INTechSenpai/sumobot/Doc positions capteur.png

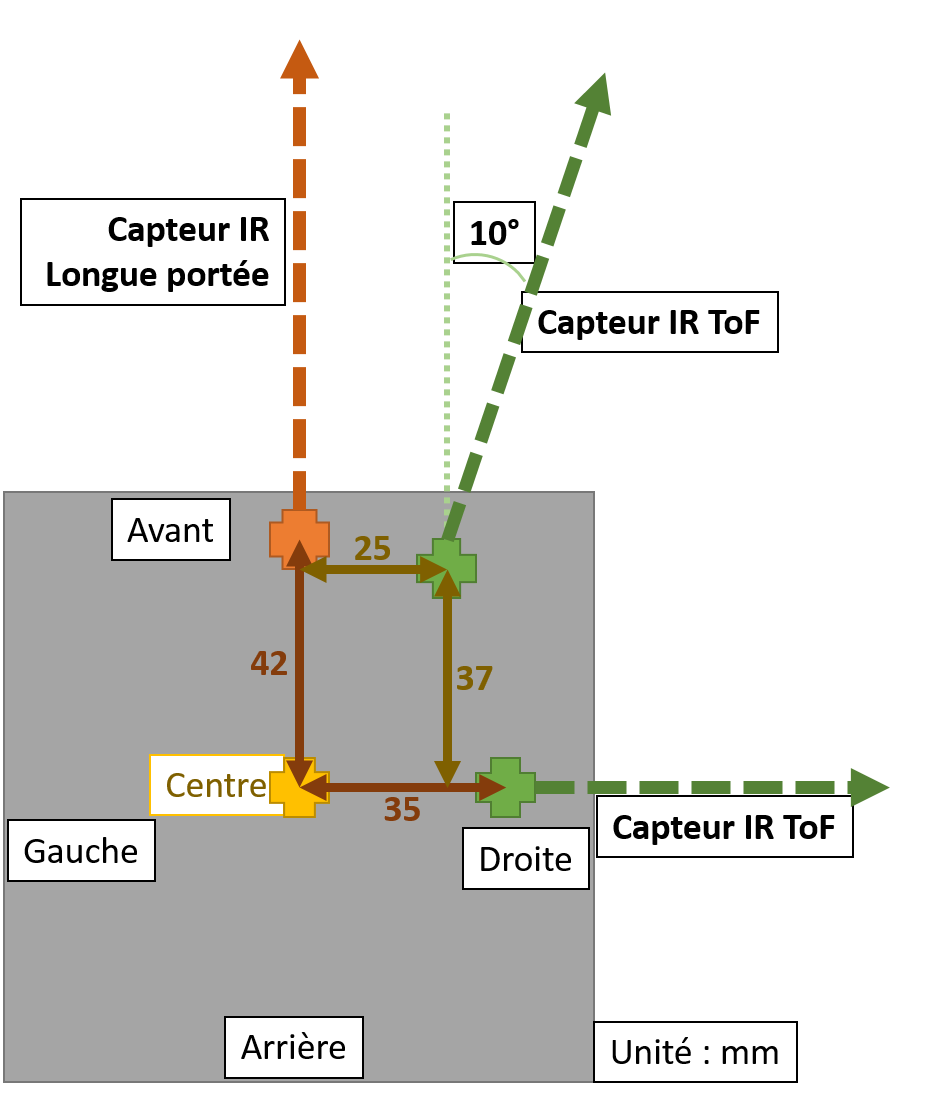
Doc positions capteur.png
