INTechSenpai/sumobot/programmation/UML/UML.png

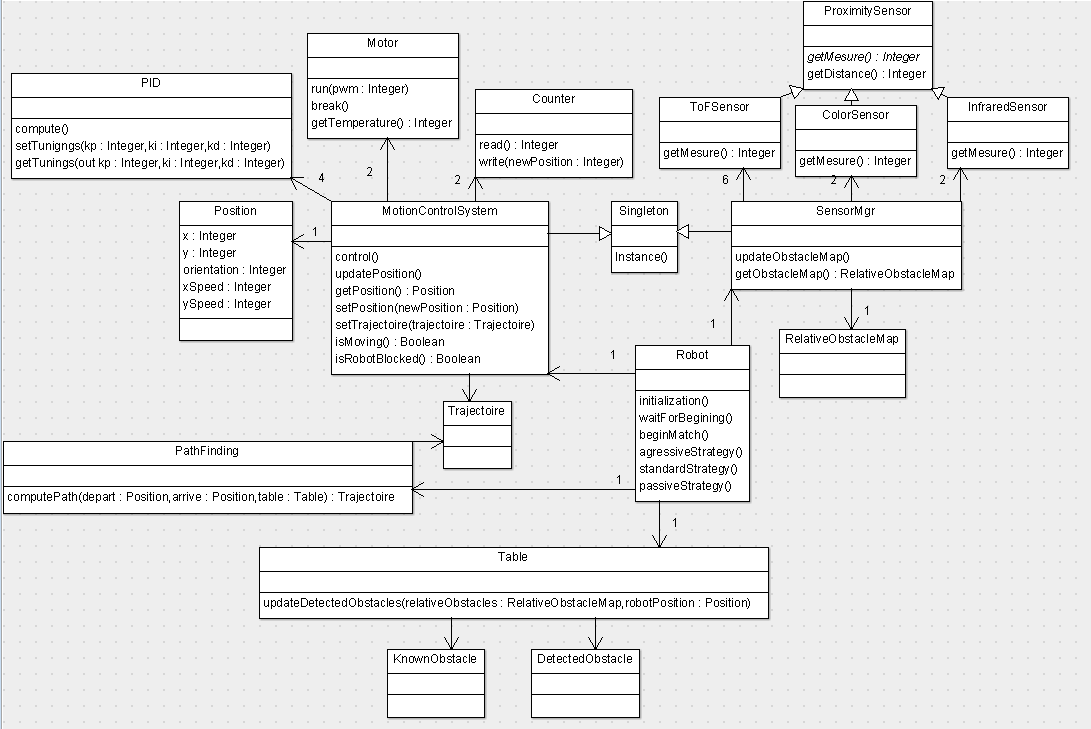
programmation/UML/UML.png
