INTechSenpai/sumobot/electronique/mainBoard.brd

## EAGLE design electronique/mainBoard.brd (2016-02-20)

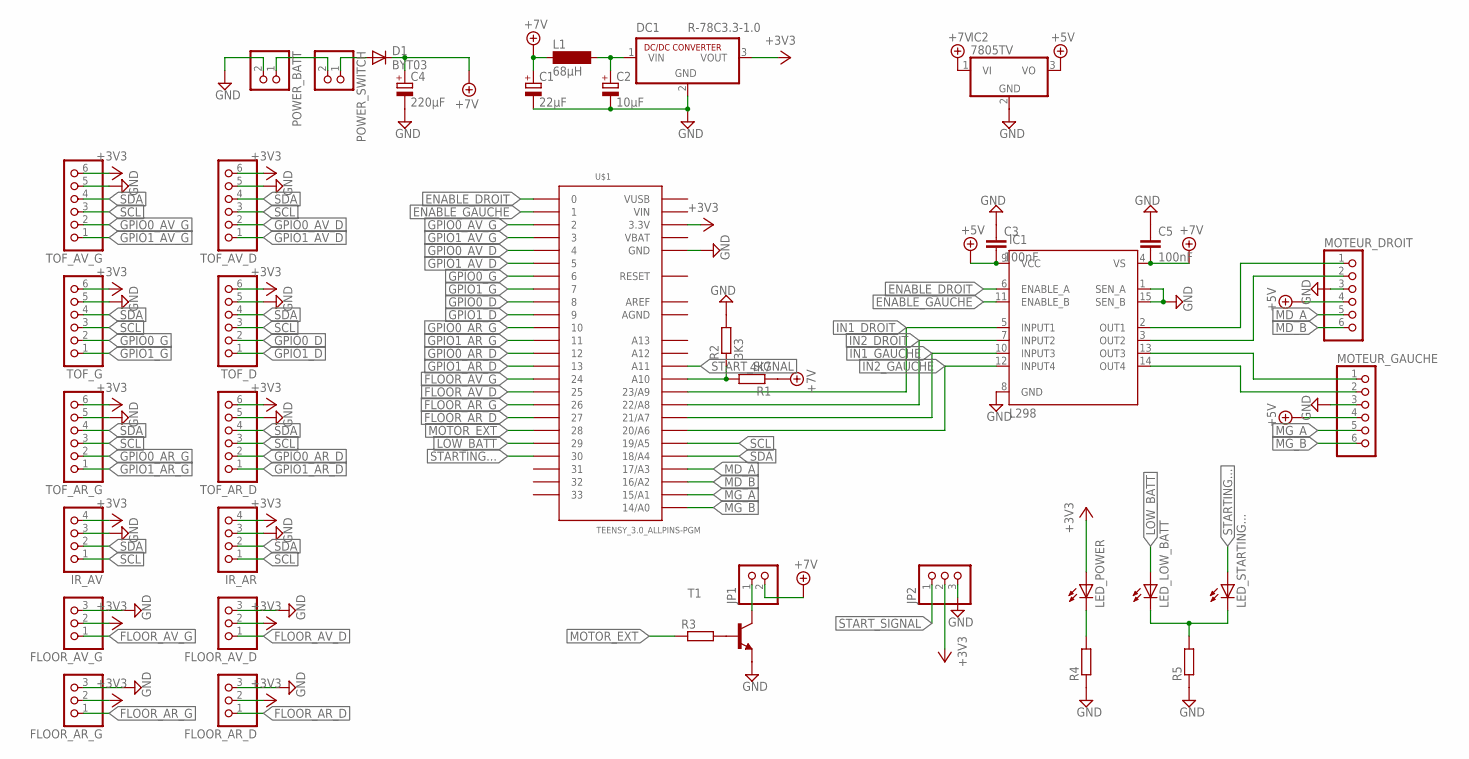
[picture p3: schematic mainBoard.sch]

Parts:
C1: 22µF; E2,5-6E
C2: 10µF; E2,5-6E
C3, C5: 100nF; C050-024X044
C4: 220µF; E2,5-7
D1: BYT03; DO27-15
DC1: R-78C3.3-1.0; SIP3
FLOOR_AR_D: PINHD-1X3; 1X03
FLOOR_AR_G: PINHD-1X3; 1X03
FLOOR_AV_D: PINHD-1X3; 1X03
FLOOR_AV_G: PINHD-1X3; 1X03
IC1: L298; MULTIWATT-15
IC2: 7805TV; TO220V
IR_AR: PINHD-1X4; 1X04
IR_AV: PINHD-1X4; 1X04
JP1: PINHD-1X2; 1X02
JP2: PINHD-1X3; 1X03
L1: 68µH; BS11
LED_LOW_BATT: LED3MM
LED_POWER: LED3MM
LED_STARTING...: LED3MM
MOTEUR_DROIT: PINHD-1X6; 1X06
MOTEUR_GAUCHE: PINHD-1X6; 1X06
POWER_BATT: PINHD-1X2; 1X02
POWER_SWITCH: PINHD-1X2; 1X02
R1: 4K7; 0204/7
R2: 3K3; 0204/7
R3, R4: R-EU_0204/7; 0204/7
R5: R-EU_0207/2V; 0207/2V
T1: 2N4124-NPN-TO92-CBE; TO92-CBE
TOF_AR_D: PINHD-1X6; 1X06
TOF_AR_G: PINHD-1X6; 1X06
TOF_AV_D: PINHD-1X6; 1X06
TOF_AV_G: PINHD-1X6; 1X06
TOF_D: PINHD-1X6; 1X06
TOF_G: PINHD-1X6; 1X06
U$1: TEENSY_3.0_ALLPINS-PGM

Connections:
+3V3: DC1.3 (VOUT), FLOOR_AR_D.2, FLOOR_AR_G.2, FLOOR_AV_D.2, FLOOR_AV_G.2, IR_AR.4, IR_AV.4, JP2.2, LED_POWER.A, TOF_AR_D.6, TOF_AR_G.6, TOF_AV_D.6, TOF_AV_G.6, TOF_D.6, TOF_G.6, U$1.3.3V, U$1.3.3V1 (3.3V), U$1.3.3V2 (3.3V)
+5V: C3.2, IC1.9 (VCC), IC2.3 (VO), MOTEUR_DROIT.4, MOTEUR_GAUCHE.4
+7V: C1.+, C4.+, C5.2, D1.C, IC1.4 (VS), IC2.1 (VI), JP1.2, L1.1, R1.1
AGND: U$1.AGND
AREF: U$1.AREF
ENABLE_DROIT: IC1.6 (ENABLE_A), U$1.0
ENABLE_GAUCHE: IC1.11 (ENABLE_B), U$1.1
FLOOR_AR_D: FLOOR_AR_D.1, U$1.27
FLOOR_AR_G: FLOOR_AR_G.1, U$1.26
FLOOR_AV_D: FLOOR_AV_D.1, U$1.25
FLOOR_AV_G: FLOOR_AV_G.1, U$1.24
GND: C1.-, C2.-, C3.1, C4.-, C5.1, DC1.2 (GND), FLOOR_AR_D.3, FLOOR_AR_G.3, FLOOR_AV_D.3, FLOOR_AV_G.3, IC1.1 (SEN_A), IC1.8 (GND), IC1.15 (SEN_B), IC2.2 (GND), IR_AR.3, IR_AV.3, JP2.3, MOTEUR_DROIT.3, MOTEUR_GAUCHE.3, POWER_BATT.2, R2.2, R4.1, R5.1, T1.E, TOF_AR_D.5, TOF_AR_G.5, TOF_AV_D.5, TOF_AV_G.5, TOF_D.5, TOF_G.5, U$1.GND, U$1.GND1 (GND), U$1.GND2 (GND)
GPIO0_AR_D: TOF_AR_D.2, U$1.12
GPIO0_AR_G: TOF_AR_G.2, U$1.10
GPIO0_AV_D: TOF_AV_D.2, U$1.4
GPIO0_AV_G: TOF_AV_G.2, U$1.2
GPIO0_D: TOF_D.2, U$1.8
GPIO0_G: TOF_G.2, U$1.6
GPIO1_AR_D: TOF_AR_D.1, U$1.13
GPIO1_AR_G: TOF_AR_G.1, U$1.11
GPIO1_AV_D: TOF_AV_D.1, U$1.5
GPIO1_AV_G: TOF_AV_G.1, U$1.3
GPIO1_D: TOF_D.1, U$1.9
GPIO1_G: TOF_G.1, U$1.7
IN1_DROIT: IC1.5 (INPUT1), U$1.23/A9
IN1_GAUCHE: IC1.10 (INPUT3), U$1.21/A7
IN2_DROIT: IC1.7 (INPUT2), U$1.22/A8
IN2_GAUCHE: IC1.12 (INPUT4), U$1.20/A6
LOW_BATT: LED_LOW_BATT.A, U$1.29
MD_A: MOTEUR_DROIT.5, U$1.17/A3
MD_B: MOTEUR_DROIT.6, U$1.16/A2
MD_OUT_A: IC1.2 (OUT1), MOTEUR_DROIT.1
MD_OUT_B: IC1.3 (OUT2), MOTEUR_DROIT.2
MG_A: MOTEUR_GAUCHE.5, U$1.15/A1
MG_B: MOTEUR_GAUCHE.6, U$1.14/A0
MG_OUT_A: IC1.13 (OUT3), MOTEUR_GAUCHE.1
MG_OUT_B: IC1.14 (OUT4), MOTEUR_GAUCHE.2
MOTOR_EXT: R3.1, U$1.28
unnamed: R3.2, T1.B
unnamed: C2.+, DC1.1 (VIN), L1.2
unnamed: JP1.1, T1.C
unnamed: POWER_BATT.1, POWER_SWITCH.2
unnamed: D1.A, POWER_SWITCH.1
unnamed: LED_POWER.K (C), R4.2
unnamed: R1.2, R2.1, U$1.A10
unnamed: LED_LOW_BATT.K (C), LED_STARTING....K (C), R5.2
SCL: IR_AR.1, IR_AV.1, TOF_AR_D.3, TOF_AR_G.3, TOF_AV_D.3, TOF_AV_G.3, TOF_D.3, TOF_G.3, U$1.19/A5
SDA: IR_AR.2, IR_AV.2, TOF_AR_D.4, TOF_AR_G.4, TOF_AV_D.4, TOF_AV_G.4, TOF_D.4, TOF_G.4, U$1.18/A4
STARTING...: LED_STARTING....A, U$1.30
START_SIGNAL: JP2.1, U$1.A11
VBAT: U$1.VBAT
VIN: U$1.VIN
VUSB: U$1.VUSB

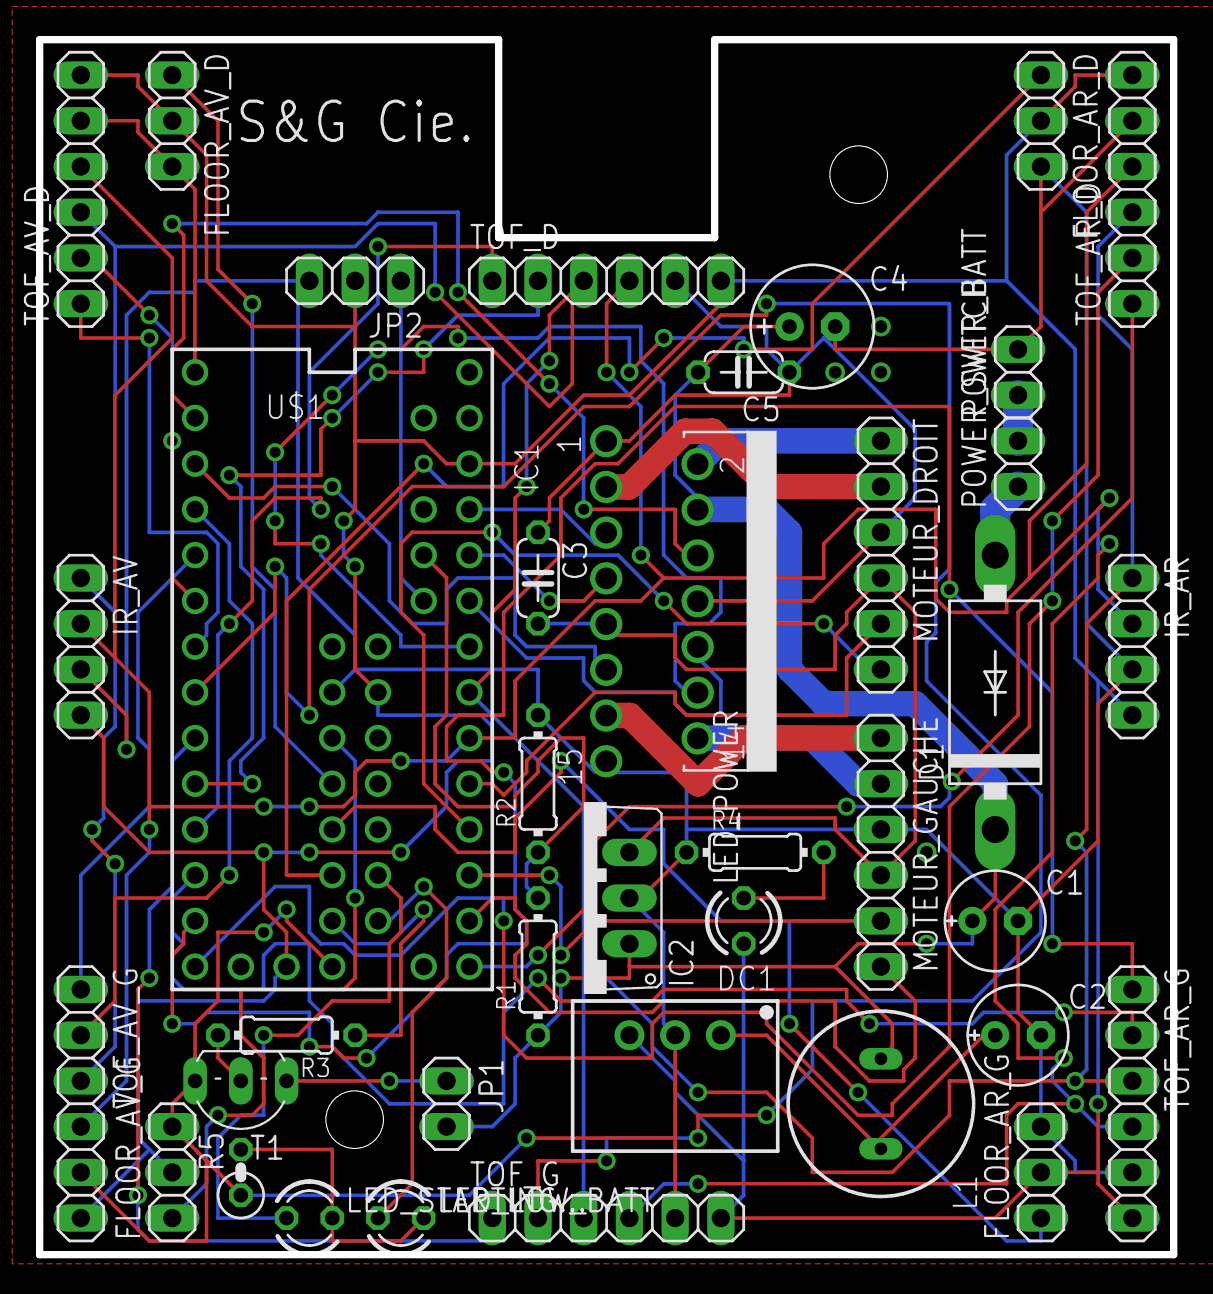
[picture p4: board mainBoard.brd from above]

Board: 2 copper layers, 63.0 x 67.5 mm, 38 parts (0 on the bottom side), 48 nets.
