INTechSenpai/sumobot/programmation/sumobot/MotionControlSystem.h

// MotionControlSystem.h

#ifndef _MOTIONCONTROLSYSTEM_h
#define _MOTIONCONTROLSYSTEM_h

#if defined(ARDUINO) && ARDUINO >= 100
	#include "arduino.h"
#else
	#include "WProgram.h"
#endif

#include "Singleton.h"
#include "Motor.h"
#include "PID.h"
#include "Average.h"
#include "Encoder.h"
#include "Path.h"
#include "Position.h"
#include "utils.h"
#include <math.h>

#define PIN_A_LEFT_ENCODER	15
#define PIN_B_LEFT_ENCODER	14
#define PIN_A_RIGHT_ENCODER	17
#define PIN_B_RIGHT_ENCODER	16

#define ROBOT_RADIUS		45.0	// Rayon du robot, en mm

#define FREQ_ASSERV			2000	// Fréquence d'asservissement (en Hz)
#define AVERAGE_SPEED_SIZE	50		// Nombre de valeurs à utiliser dans le calcul de la moyenne glissante permettant de lisser la mesure de vitesse
#define TRACKER_SIZE		1	 	// Nombre d'états consécutifs du système à stocker pour le débug

#define ERROR_AFTER_ROTATION	0.02	// Incrément de l'erreur sur l'orientation après une rotation pure, en radians
#define ERROR_AFTER_TRANSLATION	0.002	// Incrément de l'erreur sur l'orientation après une trajectoire courbe, en radians

class MotionControlSystem : public Singleton<MotionControlSystem>
{
private:
	Motor motor;
	Encoder leftEncoder;
	Encoder rightEncoder;

	// Trajectoire en cours de parcours
	Trajectory currentTrajectory;

	// Indice courant du tableau de la trajectoire courante
	// (si cet indice dépasse ta taille du tableau, la trajectoire completement parcourue)
	volatile uint32_t currentMove;

	// Position absolue du robot sur la table (en mm et radians)
	volatile Position currentPosition;
	
	// Incertitude absolue sur la position du robot
	volatile Position positionUncertainty;

	/*
	* 		Définition des variables d'état du système (position, vitesse, consigne, ...)
	*
	* 		Les unités sont :
	* 			Pour les distances		: ticks
	* 			Pour les vitesses		: ticks/seconde
	* 			Ces unités seront vraies pour une fréquence d'asservissement égale à FREQ_ASSERV
	*/


	//	Asservissement en vitesse du moteur droit
	PID rightSpeedPID;
	volatile int32_t rightSpeedSetpoint;	// ticks/seconde
	volatile int32_t currentRightSpeed;		// ticks/seconde
	volatile int32_t rightPWM;

	//	Asservissement en vitesse du moteur gauche
	PID leftSpeedPID;
	volatile int32_t leftSpeedSetpoint;		// ticks/seconde
	volatile int32_t currentLeftSpeed;		// ticks/seconde
	volatile int32_t leftPWM;

	//	Asservissement en position : translation
	PID translationPID;
	volatile int32_t translationSetpoint;	// ticks
	volatile int32_t currentDistance;		// ticks

	//	Asservissement en position : rotation
	PID rotationPID;
	volatile int32_t rotationSetpoint;		// angle absolu visé (en ticks)
	volatile int32_t currentAngle;			// ticks

	// Vitesse de déplacement : variable partagée par les deux asservissements en position
	volatile int32_t movingSpeed;		// ticks/seconde
	// Pour le calcul de l'accélération :
	volatile int32_t previousMovingSpeed; // en ticks.s^-2

	// Accélération maximale (variation maximale de movingSpeed)
	volatile int32_t maxAcceleration;	// ticks*s^-2


	//	Pour faire de jolies courbes de réponse du système, la vitesse moyenne c'est mieux !
	Average<int32_t, AVERAGE_SPEED_SIZE> averageLeftSpeed;
	Average<int32_t, AVERAGE_SPEED_SIZE> averageRightSpeed;

	// Variables d'état du mouvement
	volatile bool moving;
	volatile bool blocked;
	volatile bool paused;

	// Variables d'activation des différents PID
	volatile bool positionControlled;	//  Asservissement en position
	volatile bool leftSpeedControlled;	//	Asservissement en vitesse à gauche
	volatile bool rightSpeedControlled;	//	Asservissement en vitesse à droite
	volatile bool pwmControlled;		//	Mise à jour des PWM grâce à l'asservissement en vitesse

	// Variables de réglage de la détection de blocage physique
	unsigned int delayToStop;//En ms
	int minSpeed;// Même unité que current[..]Speed
	int speedTolerance;

	//Nombre de ticks de tolérance pour considérer qu'on est arrivé à destination
	int toleranceTranslation;
	int toleranceRotation;


	/*
	* Dispositif d'enregistrement de l'état du système pour permettre le débug
	* La valeur de TRACKER_SIZE dépend de la valeur de DEBUG.
	*/
	struct trackerType
	{
		float x;
		float y;
		float angle;

		int consigneVitesseGauche;
		int vitesseGaucheCourante;
		int pwmGauche;

		int consigneVitesseDroite;
		int vitesseDroiteCourante;
		int pwmDroit;

		int consigneTranslation;
		int translationCourante;
		int consigneVitesseTranslation;

		int consigneRotation;
		int rotationCourante;
		int consigneVitesseRotation;
	};

	trackerType trackArray[TRACKER_SIZE];
	unsigned int trackerCursor;


public:
	MotionControlSystem();

	/* Asservissement (fonctions à appeller dans l'interruption associée) */
	void control();
	void updatePosition();
	void manageStop();

	/* Tracking pour le débug */
	void track();//Stock les valeurs de débug
	void printTrackingAll();//Affiche l'intégralité du tableau de tracking
	void printTracking(); // Envoie des données pour l'asserv auto
	void printPosition();
	void resetTracking();// Reset le tableau de tracking

	/* Activation et désactivation de l'asserv */
	void enablePositionControl(bool);
	void enableLeftSpeedControl(bool);
	void enableRightSpeedControl(bool);
	void enablePwmControl(bool);

	/* Gestion des déplacements */
	void setTrajectory(const Trajectory&);
	int getMovingDirection() const;
	void deployMove(); // permet de déployer les pelles du robot (à faire en début de match)
	void resetMove(); // permet de ranger les pelles du robot (à faire pendant la préparation du match)
	void desengageMove(bool, bool);
	bool isMoving() const;
	bool isBlocked() const;
	void stop();
	void setRawPWM(int16_t, int16_t);
	void setPause(bool); // activer ou non la pause
	float getMoveProgress(); // renvoie le pourcentage de complétion du mouvement unitaire courant

private:
	void nextMove();
	bool isPhysicallyBlocked();

public:
	/* Setters et getters des constantes d'asservissement */
	void setTranslationTunings(float, float, float);
	void setRotationTunings(float, float, float);
	void setLeftSpeedTunings(float, float, float);
	void setRightSpeedTunings(float, float, float);
	void getTranslationTunings(float &, float &, float &) const;
	void getRotationTunings(float &, float &, float &) const;
	void getLeftSpeedTunings(float &, float &, float &) const;
	void getRightSpeedTunings(float &, float &, float &) const;

	/* Setter et getter de la position */
	void setPosition(const Position &);
	void getPosition(Position &);
	void resetPosition(void);
	void setDelayToStop(uint32_t);
	void setPositionUncertainty(const Position &);
	void getPositionUncertainty(Position &);

	/* Getters et setters de débug */
	void getPWM(int32_t &, int32_t &);
	void getCurrentSpeed(int32_t &, int32_t &);
	void getTicks(int32_t &, int32_t &);


	/* TEST */
	void testAsservVitesse(int speed, uint32_t duration, float kp, float ki, float kd);
	void testAsservVitesseEtPosition(int speed, int length, float kp, float ki, float kd);

};


#endif
