INTechSenpai/sumobot/programmation/sumobot/ColorSensor.h

#ifndef _COLORSENSOR_h
#define _COLORSENSOR_h

#if defined(ARDUINO) && ARDUINO >= 100
	#include "arduino.h"
#else
	#include "WProgram.h"
#endif

#include "ProximitySensor.h"
#include "utils.h"

class ColorSensor
{
public:
	ColorSensor();

	static void init(uint8_t, uint8_t, uint8_t, uint8_t, uint8_t, uint8_t, uint8_t, uint8_t);

	/* Fonction de mise à jour des données des capteurs. Déclenche une lecture sur chaque capteur. S'exécute en 10µs environ */
	static void update();

	/* 
	Renvoie les valeurs lues sur chaque capteur (une fois la lecture terminée). Si la valeur a déjà été lue la focntions renvoie 0
	Si le paramètre rawReading est à true, alors les valeurs retournées sont directement les temps mesurés 
	Sinon (cas par défaut), les valeurs retournées sont comprises entre 0 et 1000, sachant que
	1 correspond au temps minimal (blanc très blanc)
	1000 correspond au temps maximal (noir très noir)
	0 indique que la lecture n'est pas terminée ou bien que la valeur a déjà été lue.
	*/
	static void read(uint32_t & avG, uint32_t & avD, uint32_t & arG, uint32_t & arD, bool rawReading = false);

	static void calibrateBlack();

	static void calibrateWhite();

private:
	static volatile uint32_t endTimeAVg, endTimeAVd, endTimeARg, endTimeARd;
	
	static void av_g_interrupt();
	static void av_d_interrupt();
	static void ar_g_interrupt();
	static void ar_d_interrupt();

	static uint8_t powerAVg, intAVg, powerAVd, intAVd, powerARg, intARg, powerARd, intARd;

	static uint32_t beginTime;

	/* Durée minimale et maximale entre beginTime et endTime. Le minimum correspond au blanc le plus blanc. Le maximum au noir le plus noir. */
	static uint32_t maxTime, minTime;

};

#endif
