INTechSenpai/sumobot/programmation/sumobot/Table.cpp

#include "Table.h"

Table::Table()
{
	enableUpdate = false;
}

ObstacleMap Table::getObstacleMap() const
{
	return obstacleMap;
}

const std::vector<Obstacle>& Table::getMovableVisible() const
{
	return obstacleMap.movableVisible;
}

const std::vector<Obstacle>& Table::getFixedVisible() const
{
	return obstacleMap.fixedVisible;
}

const std::vector<Obstacle>& Table::getToBeSpecified() const
{
	return obstacleMap.toBeSpecified;
}

void Table::initObstacleMap(Side side)
{
	obstacleMap.fixedInvisible.clear();
	obstacleMap.fixedVisible.clear();
	obstacleMap.movableInvisible.clear();
	obstacleMap.movableVisible.clear();
	obstacleMap.oponentRobot.clear();
	obstacleMap.toBeSpecified.clear();

	Position centre;
	Obstacle cercle(centre, CIRCLE);
	Obstacle rectangle(centre, RECTANGLE);
	Obstacle edgeOfTable(centre, EDGE_OF_TABLE);


	/*
		##### Bords de table ##### 
	*/
	// Bord principal
	centre.x = 0;
	centre.y = 1000;
	edgeOfTable.setCenter(centre);
	edgeOfTable.setXRadius(1500);
	edgeOfTable.setYRadius(1000);
	obstacleMap.fixedVisible.push_back(edgeOfTable);

	// Support à coquillages n°1
	centre.x = 1500;
	centre.y = 0;
	cercle.setCenter(centre);
	cercle.setRadius(250);
	obstacleMap.fixedVisible.push_back(cercle);

	// Support à coquillages n°2
	centre.x = -1500;
	centre.y = 0;
	cercle.setCenter(centre);
	cercle.setRadius(250);
	obstacleMap.fixedVisible.push_back(cercle);



	/*
		##### Eléments de décors fixe #####
	*/
	
	// Tasseau de limite de la dune, côté x>0
	centre.x = 689;
	centre.y = 1900;
	rectangle.setCenter(centre);
	rectangle.setXRadius(11);
	rectangle.setYRadius(100);
	obstacleMap.fixedInvisible.push_back(rectangle);

	// Tasseau de limite de la dune, côté x<0
	centre.x = -689;
	centre.y = 1900;
	rectangle.setCenter(centre);
	rectangle.setXRadius(11);
	rectangle.setYRadius(100);
	obstacleMap.fixedInvisible.push_back(rectangle);

	// Tasseau de limite de NOTRE bac à sable
	if(side == GREEN)
		centre.x = 312;
	else
		centre.x = -312;
	centre.y = 761;
	rectangle.setCenter(centre);
	rectangle.setXRadius(288);
	rectangle.setYRadius(11);
	obstacleMap.fixedInvisible.push_back(rectangle);

	// Bac à sable adverse (inclu le tasseau de délimitation)
	if(side == GREEN)
		centre.x = -312;
	else
		centre.x = 312;
	centre.y = 950;
	rectangle.setCenter(centre);
	rectangle.setXRadius(288);
	rectangle.setYRadius(300);
	obstacleMap.fixedInvisible.push_back(rectangle);

	// Vitre centrale 
	centre.x = 0;
	centre.y = 950;
	rectangle.setCenter(centre);
	rectangle.setXRadius(24);
	rectangle.setYRadius(300);
	obstacleMap.fixedVisible.push_back(rectangle);

	// Serivette adverse
	if (side == GREEN)
		centre.x = -1350;
	else
		centre.x = 1350;
	centre.y = 1150;
	rectangle.setCenter(centre);
	rectangle.setXRadius(150);
	rectangle.setYRadius(250);
	obstacleMap.fixedInvisible.push_back(rectangle);

	// Dune de sable (simplifiée)
	centre.x = 0;
	centre.y = 1940;
	rectangle.setCenter(centre);
	rectangle.setXRadius(678);
	rectangle.setYRadius(60);
	obstacleMap.fixedInvisible.push_back(rectangle);


	/*
		##### Eléments de jeu #####
	*/

	// Tas de sable face à notre serviette
	if (side == GREEN)
		centre.x = 850;
	else
		centre.x = -850;
	centre.y = 1100;
	rectangle.setCenter(centre);
	rectangle.setXRadius(60);
	rectangle.setYRadius(60);
	if (side == GREEN)
		rectangle.setOrientationToPush(PI);
	else
		rectangle.setOrientationToPush(0);
	rectangle.setPriority(KNOWN_SAND_PRIORITY);
	obstacleMap.movableVisible.push_back(rectangle);



	/*
	################################
		   ## Coquillages ##
	################################
	*/
	
	// Gestion de la symétrie
	int mirror;
	if (side == GREEN)
		mirror = 1;
	else
		mirror = -1;

	// De notre côté
	centre.x = mirror * 1300;
	centre.y = 750;
	cercle.setCenter(centre);
	cercle.setRadius(40);
	cercle.setOrientationToPush(ORIENTATION_BACKWARD);
	cercle.setPriority(SHELL_PRIORITY);
	obstacleMap.movableInvisible.push_back(cercle);

	centre.x = mirror * 1300;
	centre.y = 450;
	cercle.setCenter(centre);
	cercle.setRadius(40);
	cercle.setOrientationToPush(ORIENTATION_BACKWARD);
	cercle.setPriority(SHELL_PRIORITY);
	obstacleMap.movableInvisible.push_back(cercle);

	centre.x = mirror * 800;
	centre.y = 750;
	cercle.setCenter(centre);
	cercle.setRadius(40);
	cercle.setOrientationToPush(ORIENTATION_BACKWARD);
	cercle.setPriority(SHELL_PRIORITY * 3 / 5);
	obstacleMap.movableInvisible.push_back(cercle);

	centre.x = mirror * 800;
	centre.y = 450;
	cercle.setCenter(centre);
	cercle.setRadius(40);
	obstacleMap.fixedInvisible.push_back(cercle);

	centre.x = mirror * 800;
	centre.y = 150;
	cercle.setCenter(centre);
	cercle.setRadius(40);
	cercle.setOrientationToPush(ORIENTATION_BACKWARD);
	cercle.setPriority(SHELL_PRIORITY / 5);
	obstacleMap.movableInvisible.push_back(cercle);

	centre.x = mirror * 600;
	centre.y = 550;
	cercle.setCenter(centre);
	cercle.setRadius(40);
	cercle.setOrientationToPush(ORIENTATION_BACKWARD);
	cercle.setPriority(SHELL_PRIORITY * 2 / 5);
	obstacleMap.movableInvisible.push_back(cercle);

	centre.x = mirror * 300;
	centre.y = 350;
	cercle.setCenter(centre);
	cercle.setRadius(40);
	obstacleMap.fixedInvisible.push_back(cercle);

	// Au centre
	centre.x = 0;
	centre.y = 450;
	cercle.setCenter(centre);
	cercle.setRadius(40);
	cercle.setOrientationToPush(ORIENTATION_BACKWARD);
	cercle.setPriority(SHELL_PRIORITY * 2 / 5);
	obstacleMap.movableInvisible.push_back(cercle);

	centre.x = 0;
	centre.y = 150;
	cercle.setCenter(centre);
	cercle.setRadius(40);
	cercle.setOrientationToPush(ORIENTATION_BACKWARD);
	cercle.setPriority(SHELL_PRIORITY * 2 / 5);
	obstacleMap.movableInvisible.push_back(cercle);

	// Côté adverse
	centre.x = mirror * -1300;
	centre.y = 750;
	cercle.setCenter(centre);
	cercle.setRadius(40);
	obstacleMap.fixedInvisible.push_back(cercle);

	centre.x = mirror * -1300;
	centre.y = 450;
	cercle.setCenter(centre);
	cercle.setRadius(40);
	obstacleMap.fixedInvisible.push_back(cercle);

	centre.x = mirror * -800;
	centre.y = 750;
	cercle.setCenter(centre);
	cercle.setRadius(40);
	obstacleMap.fixedInvisible.push_back(cercle);

	centre.x = mirror * -800;
	centre.y = 450;
	cercle.setCenter(centre);
	cercle.setRadius(40);
	cercle.setOrientationToPush(ORIENTATION_BACKWARD);
	cercle.setPriority(SHELL_PRIORITY * 3 / 5);
	obstacleMap.movableInvisible.push_back(cercle);

	centre.x = mirror * -800;
	centre.y = 150;
	cercle.setCenter(centre);
	cercle.setRadius(40);
	cercle.setOrientationToPush(ORIENTATION_BACKWARD);
	cercle.setPriority(SHELL_PRIORITY * 1 / 5);
	obstacleMap.movableInvisible.push_back(cercle);

	centre.x = mirror * -600;
	centre.y = 550;
	cercle.setCenter(centre);
	cercle.setRadius(40);
	obstacleMap.fixedInvisible.push_back(cercle);

	centre.x = mirror * -300;
	centre.y = 350;
	cercle.setCenter(centre);
	cercle.setRadius(40);
	obstacleMap.fixedInvisible.push_back(cercle);

}

bool Table::updateObstacleMap(const RelativeObstacleMap & relativeObstacleMap, Position & notrePosition, const Position & positionUncertainty)
{
	bool positionModified = false;

	if (enableUpdate)
	{
		DetectionPoint tabDetection[NB_CAPTEURS];
		fillDetectionPoints(tabDetection, notrePosition, relativeObstacleMap);
		interpreteDetectionPoints(tabDetection, notrePosition, positionUncertainty);
		/*
		for (int i = 0; i < NB_CAPTEURS; i++)
		{
			if (tabDetection[i].isAnObstacle)
			{
				Serial.printf("(%d) [x: %g  y: %g] ", i, tabDetection[i].x, tabDetection[i].y);
				switch (tabDetection[i].associatedObstacleType)
				{
				case FIXED_VISIBLE:
					Serial.print("FIXED_VISIBLE");
					break;
				case FIXED_INVISIBLE:
					Serial.print("FIXED_INVISIBLE");
					break;
				case MOVABLE_VISIBLE:
					Serial.print("MOVABLE_VISIBLE");
					break;
				case MOVABLE_INVISIBLE:
					Serial.print("MOVABLE_INVISIBLE");
					break;
				case OPONENT_ROBOT:
					Serial.print("OPONENT_ROBOT");
					break;
				case TO_BE_SPECIFIED:
					Serial.print("TO_BE_SPECIFIED");
					break;
				case NONE:
					Serial.print("NONE");
					break;
				default:
					break;
				}
				Serial.println();
			}
		}
		*/
		positionModified = moveRobotToMatchFixedObstacles(tabDetection, notrePosition);
		moveObstaclesToMatchDetection(tabDetection, notrePosition, positionUncertainty);
		deleteUndetectedObstacles(tabDetection, notrePosition);
		addObstaclesToBeDeterminated(tabDetection, notrePosition);
		deleteOutdatedObstacles();
		updateMoveAllowed(tabDetection, relativeObstacleMap);
		
	}
	else
	{
		forwardMoveAllowed = true;
		backwardMoveAllowed = true;
	}

	return positionModified;
}

void Table::enableUpdateObstacleMap(bool enable)
{
	enableUpdate = enable;
	lastChanceAvoiding = enable;
	if (!enable)
	{
		obstacleMap.toBeSpecified.clear();
	}
}

void Table::enableLastChanceAvoiding(bool enable)
{
	lastChanceAvoiding = enable;
}

size_t Table::getToBeSpecifiedLength()
{
	return obstacleMap.toBeSpecified.size();
}

void Table::fillDetectionPoints(DetectionPoint tabDetection[NB_CAPTEURS], const Position & notrePosition, const RelativeObstacleMap & relativeObstacleMap)
{
	if (NB_CAPTEURS != 8)
		return; // On sait jamais, ça évitera des SegFault ^^

	static Position point;
	static double theta;
	static int norme;
	static float xRotated, yRotated;

	/*
	##### Placement des points de détection #####
	*/
	// Capteur AVANT (n°0)
	theta = notrePosition.orientation;
	norme = relativeObstacleMap.avant + 42;
	point.x = norme*cos(theta);
	point.y = norme*sin(theta);
	point.x += notrePosition.x;
	point.y += notrePosition.y;
	tabDetection[0].x = point.x;
	tabDetection[0].y = point.y;
	tabDetection[0].isAnObstacle = !(relativeObstacleMap.avant == IR_INFINITY || relativeObstacleMap.avant == 0);
	tabDetection[0].isReliable = false;

	// Capteur ARRIERE (n°1)
	theta = notrePosition.orientation + PI;
	norme = relativeObstacleMap.arriere + 42;
	point.x = norme*cos(theta);
	point.y = norme*sin(theta);
	point.x += notrePosition.x;
	point.y += notrePosition.y;
	tabDetection[1].x = point.x;
	tabDetection[1].y = point.y;
	tabDetection[1].isAnObstacle = !(relativeObstacleMap.arriere == IR_INFINITY || relativeObstacleMap.arriere == 0);
	tabDetection[1].isReliable = false;

	// Capteur GAUCHE (n°2)
	theta = notrePosition.orientation + M_PI_2;
	norme = relativeObstacleMap.gauche + 35;
	point.x = norme*cos(theta);
	point.y = norme*sin(theta);
	point.x += notrePosition.x;
	point.y += notrePosition.y;
	tabDetection[2].x = point.x;
	tabDetection[2].y = point.y;
	tabDetection[2].isAnObstacle = !(relativeObstacleMap.gauche == TOF_INFINITY || relativeObstacleMap.gauche == 0);
	tabDetection[2].isReliable = true;

	// Capteur DROIT (n°3)
	theta = notrePosition.orientation - M_PI_2;
	norme = relativeObstacleMap.droit + 35;
	point.x = norme*cos(theta);
	point.y = norme*sin(theta);
	point.x += notrePosition.x;
	point.y += notrePosition.y;
	tabDetection[3].x = point.x;
	tabDetection[3].y = point.y;
	tabDetection[3].isAnObstacle = !(relativeObstacleMap.droit == TOF_INFINITY || relativeObstacleMap.droit == 0);
	tabDetection[3].isReliable = true;

	// Capteur AVANT GAUCHE (n°4)
	theta = 0.1745329251994; // angle de 10°
	norme = relativeObstacleMap.avantGauche;
	point.x = norme*cos(theta);
	point.y = norme*sin(theta);
	point.x += 37;
	point.y += 25;
	theta = notrePosition.orientation;
	xRotated = point.x * cos(theta) - point.y * sin(theta);
	yRotated = point.x * sin(theta) + point.y * cos(theta);
	point.x = xRotated + notrePosition.x;
	point.y = yRotated + notrePosition.y;
	tabDetection[4].x = point.x;
	tabDetection[4].y = point.y;
	tabDetection[4].isAnObstacle = !(relativeObstacleMap.avantGauche == TOF_INFINITY || relativeObstacleMap.avantGauche == 0);
	tabDetection[4].isReliable = true;

	// Capteur AVANT DROIT (n°5)
	theta = -0.1745329251994; // angle de -10°
	norme = relativeObstacleMap.avantDroit;
	point.x = norme*cos(theta);
	point.y = norme*sin(theta);
	point.x += 37;
	point.y -= 25;
	theta = notrePosition.orientation;
	xRotated = point.x * cos(theta) - point.y * sin(theta);
	yRotated = point.x * sin(theta) + point.y * cos(theta);
	point.x = xRotated + notrePosition.x;
	point.y = yRotated + notrePosition.y;
	tabDetection[5].x = point.x;
	tabDetection[5].y = point.y;
	tabDetection[5].isAnObstacle = !(relativeObstacleMap.avantDroit == TOF_INFINITY || relativeObstacleMap.avantDroit == 0);
	tabDetection[5].isReliable = true;

	// Capteur ARRIERE GAUCHE (n°6)
	theta = 2.96705972839036; // angle de PI - 10°
	norme = relativeObstacleMap.arriereGauche;
	point.x = norme*cos(theta);
	point.y = norme*sin(theta);
	point.x -= 37;
	point.y += 25;
	theta = notrePosition.orientation;
	xRotated = point.x * cos(theta) - point.y * sin(theta);
	yRotated = point.x * sin(theta) + point.y * cos(theta);
	point.x = xRotated + notrePosition.x;
	point.y = yRotated + notrePosition.y;
	tabDetection[6].x = point.x;
	tabDetection[6].y = point.y;
	tabDetection[6].isAnObstacle = !(relativeObstacleMap.arriereGauche == TOF_INFINITY || relativeObstacleMap.arriereGauche == 0);
	tabDetection[6].isReliable = true;

	// Capteur ARRIERE DROIT (n°7)
	theta = 3.31612557878922; // angle de PI + 10°
	norme = relativeObstacleMap.arriereDroit;
	point.x = norme*cos(theta);
	point.y = norme*sin(theta);
	point.x -= 37;
	point.y -= 25;
	theta = notrePosition.orientation;
	xRotated = point.x * cos(theta) - point.y * sin(theta);
	yRotated = point.x * sin(theta) + point.y * cos(theta);
	point.x = xRotated + notrePosition.x;
	point.y = yRotated + notrePosition.y;
	tabDetection[7].x = point.x;
	tabDetection[7].y = point.y;
	tabDetection[7].isAnObstacle = !(relativeObstacleMap.arriereDroit == TOF_INFINITY || relativeObstacleMap.arriereDroit == 0);
	tabDetection[7].isReliable = true;
}

void Table::interpreteDetectionPoints(DetectionPoint tabDetection[NB_CAPTEURS], const Position & notrePosition, const Position & notreIncertitude)
{
	Position incertitudeAugmentee(notreIncertitude.x + NEW_OBSTACLE_RADIUS, notreIncertitude.y + NEW_OBSTACLE_RADIUS, notreIncertitude.orientation);

	for (int i = 0; i < NB_CAPTEURS; i++)
	{
		tabDetection[i].associatedObstacleType = NONE;

		if (tabDetection[i].isAnObstacle)
		{
			// Movable Invisible
			for (size_t indiceObstacle = 0; indiceObstacle < obstacleMap.movableInvisible.size(); indiceObstacle++)
			{
				if (isThisPointThisObstacle(tabDetection[i], obstacleMap.movableInvisible.at(indiceObstacle), notreIncertitude))
				{
					tabDetection[i].associatedObstacleType = MOVABLE_INVISIBLE;
					tabDetection[i].associatedObstacle = indiceObstacle;
				}
			}

			// Fixed Invisible
			for (size_t indiceObstacle = 0; indiceObstacle < obstacleMap.fixedInvisible.size(); indiceObstacle++)
			{
				if (isThisPointThisObstacle(tabDetection[i], obstacleMap.fixedInvisible.at(indiceObstacle), notreIncertitude))
				{
					tabDetection[i].associatedObstacleType = FIXED_INVISIBLE;
					tabDetection[i].associatedObstacle = indiceObstacle;
				}
			}

			// To Be specified
			for (size_t indiceObstacle = 0; indiceObstacle < obstacleMap.toBeSpecified.size(); indiceObstacle++)
			{
				if (isThisPointThisObstacle(tabDetection[i], obstacleMap.toBeSpecified.at(indiceObstacle), notreIncertitude))
				{
					tabDetection[i].associatedObstacleType = TO_BE_SPECIFIED;
					tabDetection[i].associatedObstacle = indiceObstacle;
					obstacleMap.toBeSpecified.at(indiceObstacle).justSeen();
				}
			}

			// Movable Visible
			for (size_t indiceObstacle = 0; indiceObstacle < obstacleMap.movableVisible.size(); indiceObstacle++)
			{
				if (isThisPointThisObstacle(tabDetection[i], obstacleMap.movableVisible.at(indiceObstacle), notreIncertitude))
				{
					tabDetection[i].associatedObstacleType = MOVABLE_VISIBLE;
					tabDetection[i].associatedObstacle = indiceObstacle;
					obstacleMap.movableVisible.at(indiceObstacle).justSeen();
				}
			}

			// Fixed Visible
			for (size_t indiceObstacle = 0; indiceObstacle < obstacleMap.fixedVisible.size(); indiceObstacle++)
			{
				if (isThisPointThisObstacle(tabDetection[i], obstacleMap.fixedVisible.at(indiceObstacle), incertitudeAugmentee))
				{
					tabDetection[i].associatedObstacleType = FIXED_VISIBLE;
					tabDetection[i].associatedObstacle = indiceObstacle;
				}
			}

			// Oponent Robot
			for (size_t indiceObstacle = 0; indiceObstacle < obstacleMap.oponentRobot.size(); indiceObstacle++)
			{
				if (isThisPointThisObstacle(tabDetection[i], obstacleMap.oponentRobot.at(indiceObstacle), notreIncertitude))
				{
					tabDetection[i].associatedObstacleType = OPONENT_ROBOT;
					tabDetection[i].associatedObstacle = indiceObstacle;
					obstacleMap.oponentRobot.at(indiceObstacle).justSeen();
				}
			}
		}
	}
}

bool Table::isThisPointThisObstacle(const DetectionPoint & detectionPoint, const Obstacle & obstacle, const Position & uncertainty)
{
	Position centre;
	obstacle.getCenter(centre);

	if (obstacle.getShape() == CIRCLE)
	{
		float squaredUncertainty = square(uncertainty.x) + square(uncertainty.y);
		float squaredDistance = square(detectionPoint.x - centre.x) + square(detectionPoint.y - centre.y);

		return ABS(square(obstacle.getRadius()) - squaredDistance) <= squaredUncertainty;
	}
	else if (obstacle.getShape() == RECTANGLE)
	{
		if (centre.orientation == 0)
		{
			bool closeToXSide = 
				(
					ABS(centre.x + obstacle.getXRadius() - detectionPoint.x) <= uncertainty.x || 
					ABS(centre.x - obstacle.getXRadius() - detectionPoint.x) <= uncertainty.x
				) 
				&&
				(
					ABS(centre.y - detectionPoint.y) <= obstacle.getYRadius() + uncertainty.y
				);
			
			bool closeToYSide = 
				(
					ABS(centre.y + obstacle.getYRadius() - detectionPoint.y) <= uncertainty.y ||
					ABS(centre.y - obstacle.getYRadius() - detectionPoint.y) <= uncertainty.y
				)
				&&
				(
					ABS(centre.x - detectionPoint.x) <= obstacle.getXRadius() + uncertainty.x
				);

			return closeToXSide || closeToYSide;
		}
		else
		{// L'obstacle a subi une rotation, on l'assimile donc désormai à un cercle
			float squaredUncertainty = square(uncertainty.x) + square(uncertainty.y);
			float squaredDistance = square(detectionPoint.x - centre.x) + square(detectionPoint.y - centre.y);

			return ABS(square(obstacle.getXRadius()) + square(obstacle.getYRadius()) - squaredDistance) <= squaredUncertainty;
		}
	}
	else if (obstacle.getShape() == EDGE_OF_TABLE)
	{
		bool closeToXEdge = ABS(detectionPoint.x - centre.x) >= obstacle.getXRadius() - uncertainty.x;
		bool closeToYEdge = ABS(detectionPoint.y - centre.y) >= obstacle.getYRadius() - uncertainty.y;

		return closeToXEdge || closeToYEdge;
	}

	return false;
}

bool Table::moveRobotToMatchFixedObstacles(DetectionPoint tabDetection[NB_CAPTEURS], Position & position)
{
	bool positionModified = false;
	bool bordDeTableVisible = false;

	/* On déplace le robot en fonction des obstacles fixes vus par les capteurs fiables */
	for (int i = 0; i < NB_CAPTEURS; i++)
	{
		if (tabDetection[i].associatedObstacleType == FIXED_VISIBLE && tabDetection[i].isReliable)
		{
			ObstacleShape obstacleShape = obstacleMap.fixedVisible.at(tabDetection[i].associatedObstacle).getShape();

			if (obstacleShape == CIRCLE || obstacleShape == EDGE_OF_TABLE)
			{
				bordDeTableVisible = true;
			}

			float xOffset = 0, yOffset = 0; // Le robot ainsi que tous les points de détection seront déplacés selon cet offset
			calculateOffsetToMatch(tabDetection[i], xOffset, yOffset);

			if (xOffset != 0 || yOffset != 0)
			{
				positionModified = true;
			}

			position.x += xOffset;
			position.y += yOffset;
			for (int j = 0; j < NB_CAPTEURS; j++)
			{
				tabDetection[j].x += xOffset;
				tabDetection[j].y += yOffset;
			}
		}
	}

	/* Si le robot est proche d'un bord de table (<150mm) il doit nécéssairement le voir */
	if (ABS(position.x) >= 1350 || ABS(position.y - 1000) >= 850)
	{
		if (!bordDeTableVisible)
		{ // Si on ne voit pas le bord de table, on éloigne le robot afin que d(robot, bordDeTable) = 200mm
			positionModified = true;

			float xOffset = 0, yOffset = 0;

			if (position.x >= 1350)
			{
				xOffset = 1300 - position.x;
			}
			else if (position.x <= -1350)
			{
				xOffset = -1300 - position.x;
			}

			if (position.y >= 1850)
			{
				yOffset = 1800 - position.y;
			}
			else if (position.y <= 150)
			{
				yOffset = 200 - position.y;
			}

			position.x += xOffset;
			position.y += yOffset;
			for (int j = 0; j < NB_CAPTEURS; j++)
			{
				tabDetection[j].x += xOffset;
				tabDetection[j].y += yOffset;
			}
		}
	}

	return positionModified;
}

void Table::moveObstaclesToMatchDetection(DetectionPoint tabDetection[NB_CAPTEURS], const Position & notrePosition, const Position & incertitude)
{
	for (int i = 0; i < NB_CAPTEURS; i++)
	{
		if (tabDetection[i].associatedObstacleType == MOVABLE_VISIBLE && tabDetection[i].isReliable)
		{
			float xOffset = 0, yOffset = 0;
			calculateOffsetToMatch(tabDetection[i], xOffset, yOffset);

			Position centre;
			obstacleMap.movableVisible.at(tabDetection[i].associatedObstacle).getCenter(centre);
			centre.x -= xOffset;
			centre.y -= yOffset;
			obstacleMap.movableVisible.at(tabDetection[i].associatedObstacle).setCenter(centre);

			if (i >= 4) // Pour les capteurs ToF frontaux
			{
				/* Gestion de la cohérence des NON-Détections */
				// Indices des capteurs à considérer
				int tofOppose, capteurFrontal;

				// Capteur AVANT-GAUCHE
				if (i == 4)
				{
					tofOppose = 5;
					capteurFrontal = 0;
				}
				// Capteur AVANT-DROIT
				else if (i == 5)
				{
					tofOppose = 4;
					capteurFrontal = 0;
				}
				// Capteur ARRIERE-GAUCHE
				else if (i == 6)
				{
					tofOppose = 7;
					capteurFrontal = 1;
				}
				// Capteur ARRIERE-GAUCHE
				else if (i == 7)
				{
					tofOppose = 6;
					capteurFrontal = 1;
				}
				else
				{
					Serial.println("Table::moveObstaclesToMatchDetection::error");
					tofOppose = 5;
					capteurFrontal = 0;
				}

				float orientation = fmodulo(notrePosition.orientation + M_PI_4, 2 * PI);
				bool correctionX;

				if (orientation < M_PI_2)
				{
					correctionX = false;
				}
				else if (orientation < M_PI)
				{
					correctionX = true;
				}
				else if (orientation < M_PI + M_PI_2)
				{
					correctionX = false;
				}
				else
				{
					correctionX = true;
				}

				float oneDimUncertainty = sqrt(square(incertitude.x) + square(incertitude.y));

				if (!isObstacleCoherentWithSensor(tabDetection[tofOppose], notrePosition, tabDetection[i].associatedObstacleType, tabDetection[i].associatedObstacle, oneDimUncertainty))
				{// Le capteur ToF opposé ne voit pas l'obstacle en question alors qu'il devrait

					if (isObstacleCoherentWithSensor(tabDetection[capteurFrontal], notrePosition, tabDetection[i].associatedObstacleType, tabDetection[i].associatedObstacle, oneDimUncertainty))
					{// Le capteur central, en revanche, confirme cet obstacle
						if (correctionX)
						{
							centre.x = (tabDetection[i].x + tabDetection[capteurFrontal].x) / 2;
						}
						else
						{
							centre.y = (tabDetection[i].y + tabDetection[capteurFrontal].y) / 2;
						}
					}
					else
					{// Le capteur central ne le voit pas non plus alors qu'il devrait
						if (correctionX)
						{
							centre.x = tabDetection[i].x;
						}
						else
						{
							centre.y = tabDetection[i].y;
						}
					}
				}
				else
				{
					if (correctionX)
					{
						centre.x = tabDetection[capteurFrontal].x;
					}
					else
					{
						centre.y = tabDetection[capteurFrontal].y;
					}
				}
				obstacleMap.movableVisible.at(tabDetection[i].associatedObstacle).setCenter(centre);
			}
		}
		else if (tabDetection[i].associatedObstacleType == TO_BE_SPECIFIED && tabDetection[i].isReliable)
		{
			float xOffset = 0, yOffset = 0;
			calculateOffsetToMatch(tabDetection[i], xOffset, yOffset);

			Position centre;
			obstacleMap.toBeSpecified.at(tabDetection[i].associatedObstacle).getCenter(centre);
			centre.x -= xOffset;
			centre.y -= yOffset;
			obstacleMap.toBeSpecified.at(tabDetection[i].associatedObstacle).setCenter(centre);
		}
		
	}
}

void Table::deleteUndetectedObstacles(DetectionPoint tabDetection[NB_CAPTEURS], const Position & notrePosition)
{
	Position obstacleCenter;
	float squaredObstacleRadius;
	ObstacleShape shape;

	for (int i = 0; i < NB_CAPTEURS; i++)
	{
		if (!tabDetection[i].isAnObstacle && tabDetection[i].isReliable)
		{
			for (size_t j = 0; j < obstacleMap.movableVisible.size(); j++)
			{
				obstacleMap.movableVisible.at(j).getCenter(obstacleCenter);
				shape = obstacleMap.movableVisible.at(j).getShape();
				if (shape == CIRCLE)
				{
					squaredObstacleRadius = square(obstacleMap.movableVisible.at(j).getRadius());
				}
				else
				{
					squaredObstacleRadius = square(obstacleMap.movableVisible.at(j).getXRadius()) + square(obstacleMap.movableVisible.at(j).getYRadius());
				}

				if (isObstacleInSight(notrePosition, obstacleCenter, sqrt(squaredObstacleRadius), tabDetection[i].x, tabDetection[i].y))
				{
					obstacleMap.movableVisible.at(j).decreaseTTL(TTL_DECREASE_NOT_SEEN);
				}
			}

			for (size_t j = 0; j < obstacleMap.toBeSpecified.size(); j++)
			{
				obstacleMap.toBeSpecified.at(j).getCenter(obstacleCenter);
				shape = obstacleMap.toBeSpecified.at(j).getShape();
				if (shape == CIRCLE)
				{
					squaredObstacleRadius = square(obstacleMap.toBeSpecified.at(j).getRadius());
				}
				else
				{
					squaredObstacleRadius = square(obstacleMap.toBeSpecified.at(j).getXRadius()) + square(obstacleMap.toBeSpecified.at(j).getYRadius());
				}

				if (isObstacleInSight(notrePosition, obstacleCenter, sqrt(squaredObstacleRadius), tabDetection[i].x, tabDetection[i].y))
				{
					obstacleMap.toBeSpecified.at(j).decreaseTTL(TTL_DECREASE_NOT_SEEN);
				}
			}

			for (size_t j = 0; j < obstacleMap.oponentRobot.size(); j++)
			{
				obstacleMap.oponentRobot.at(j).getCenter(obstacleCenter);
				shape = obstacleMap.oponentRobot.at(j).getShape();
				if (shape == CIRCLE)
				{
					squaredObstacleRadius = square(obstacleMap.oponentRobot.at(j).getRadius());
				}
				else
				{
					squaredObstacleRadius = square(obstacleMap.oponentRobot.at(j).getXRadius()) + square(obstacleMap.oponentRobot.at(j).getYRadius());
				}

				if (isObstacleInSight(notrePosition, obstacleCenter, sqrt(squaredObstacleRadius), tabDetection[i].x, tabDetection[i].y))
				{
					obstacleMap.oponentRobot.at(j).decreaseTTL(TTL_DECREASE_NOT_SEEN);
				}
			}
		}
	}
}

void Table::addObstaclesToBeDeterminated(DetectionPoint tabDetection[NB_CAPTEURS], const Position & notrePosition)
{
	for (int i = 0; i < NB_CAPTEURS; i++)
	{
		if (tabDetection[i].associatedObstacleType == NONE && tabDetection[i].isAnObstacle)
		{
			// On se place dans un repère centré sur le robot
			float xDetection = tabDetection[i].x - notrePosition.x;
			float yDetection = tabDetection[i].y - notrePosition.y;
			float distanceToDetectionPoint = sqrt(square(xDetection) + square(yDetection));

			Position centreObstacle;
			centreObstacle.x = xDetection * (distanceToDetectionPoint + NEW_OBSTACLE_RADIUS) / distanceToDetectionPoint;
			centreObstacle.y = yDetection * (distanceToDetectionPoint + NEW_OBSTACLE_RADIUS) / distanceToDetectionPoint;
			centreObstacle.orientation = 0;
			
			// On revient dans le repère de la table
			centreObstacle.x += notrePosition.x;
			centreObstacle.y += notrePosition.y;

			//Serial.printf("#NEW#(%d) xd:%g  yd:%g  xO:%g  yO:%g (x:%g  y:%g) t:%d\n", i, xDetection, yDetection, centreObstacle.x, centreObstacle.y, notrePosition.x, notrePosition.y, obstacleMap.toBeSpecified.size());

			Obstacle newObstacle(centreObstacle, CIRCLE);
			newObstacle.setRadius(NEW_OBSTACLE_RADIUS);
			newObstacle.justSeen();
			newObstacle.setTTL(TTL_TO_BE_SPECIFIED);

			if (obstacleMap.toBeSpecified.size() >= MAX_SIZE_OBSTACLE_MAP)
			{
				obstacleMap.toBeSpecified.clear();
			}

			obstacleMap.toBeSpecified.push_back(newObstacle);
			tabDetection[i].associatedObstacleType = TO_BE_SPECIFIED;
			tabDetection[i].associatedObstacle = obstacleMap.toBeSpecified.size() - 1;
		}
	}
}


void Table::calculateOffsetToMatch(const DetectionPoint & detectionPoint, float & xOffset, float & yOffset)
{
	Obstacle obstacle;
	switch (detectionPoint.associatedObstacleType)
	{
	case FIXED_VISIBLE:
		obstacle = obstacleMap.fixedVisible.at(detectionPoint.associatedObstacle);
		break;
	case FIXED_INVISIBLE:
		obstacle = obstacleMap.fixedInvisible.at(detectionPoint.associatedObstacle);
		break;
	case MOVABLE_VISIBLE:
		obstacle = obstacleMap.movableVisible.at(detectionPoint.associatedObstacle);
		break;
	case MOVABLE_INVISIBLE:
		obstacle = obstacleMap.movableInvisible.at(detectionPoint.associatedObstacle);
		break;
	case TO_BE_SPECIFIED:
		obstacle = obstacleMap.toBeSpecified.at(detectionPoint.associatedObstacle);
		break;
	case OPONENT_ROBOT:
		obstacle = obstacleMap.oponentRobot.at(detectionPoint.associatedObstacle);
		break;
	default:
		xOffset = 0;
		yOffset = 0;
		return;
		break;
	}

	Position centre;
	obstacle.getCenter(centre);

	float dx, dy; // Position du point de détection relativement au centre du rectangle
	dx = detectionPoint.x - centre.x;
	dy = detectionPoint.y - centre.y;

	if (obstacle.getShape() == CIRCLE)
	{
		float d; // Distance centre <--> point de détection
		d = sqrt(square(dx) + square(dy));

		xOffset = (obstacle.getRadius()) * dx / d - dx;
		yOffset = (obstacle.getRadius()) * dy / d - dy;
	}
	else
	{
		if (centre.orientation == 0)
		{
			float dxp, dxm, dyp, dym; // Distances point de détection <--> arrêtes du rectangle
			dxm = -(obstacle.getXRadius() + dx);
			dxp = obstacle.getXRadius() - dx;
			dym = -(obstacle.getYRadius() + dy);
			dyp = obstacle.getYRadius() - dy;

			if (ABS(dx) > obstacle.getXRadius() && ABS(dy) > obstacle.getYRadius())
			{
				if (dx > 0)
				{
					xOffset = dxp;
				}
				else
				{
					xOffset = dxm;
				}

				if (dy > 0)
				{
					yOffset = dyp;
				}
				else
				{
					yOffset = dym;
				}
			}
			else
			{
				if (ABS(dxm) < MIN(MIN(ABS(dxp), ABS(dym)), ABS(dyp)))
				{// dxm est le min en valeur absolue
					xOffset = dxm;
					yOffset = 0;
				}
				else if (ABS(dxp) < MIN(MIN(ABS(dxm), ABS(dym)), ABS(dyp)))
				{// dxp est le min en valeur absolue
					xOffset = dxp;
					yOffset = 0;
				}
				else if (ABS(dym) < MIN(MIN(ABS(dxp), ABS(dxm)), ABS(dyp)))
				{// dym est le min en valeur absolue
					xOffset = 0;
					yOffset = dym;
				}
				else
				{// dyp est le min en valeur absolue
					xOffset = 0;
					yOffset = dyp;
				}
			}
		}
		else
		{// Les rectanges inclinés sont traités comme des cercles (le cercle circonscrit au rectangle)

			float radius; // Rayon du cercle circonscrit au rectangle
			float d; // Distance centre <--> point de détection
			
			radius = sqrt(square(obstacle.getXRadius()) + square(obstacle.getYRadius()));
			d = sqrt(square(dx) + square(dy));

			xOffset = radius * dx / d - dx;
			yOffset = radius * dy / d - dy;
		}
	}
}

bool Table::isObstacleInSight(const Position & robotCenter, const Position & obstacleCenter, float obstacleRadius, float xHorizon, float yHorizon, float uncertainty)
{
	float horizonLength = sqrt(square(xHorizon - robotCenter.x) + square(yHorizon - robotCenter.y));
	float squaredDistanceToObstacle = square(obstacleCenter.x - robotCenter.x) + square(obstacleCenter.y - robotCenter.y);
	
	float distanceToProjection = ((obstacleCenter.x - robotCenter.x) * (xHorizon - robotCenter.x) + (obstacleCenter.y - robotCenter.y) * (yHorizon - robotCenter.y)) / horizonLength;

	float squaredDistanceToLineOfSight = squaredDistanceToObstacle - square(distanceToProjection);

	return squaredDistanceToLineOfSight <= square(obstacleRadius + uncertainty) && (distanceToProjection <= horizonLength && distanceToProjection >= 0);
}

void Table::deleteOutdatedObstacles()
{
	for (size_t i = 0; i < obstacleMap.movableVisible.size(); i++)
	{
		if (obstacleMap.movableVisible.at(i).getTTL() <= millis() - obstacleMap.movableVisible.at(i).getLastTimeSeen())
			obstacleMap.movableVisible.erase(obstacleMap.movableVisible.begin() + i);
	}

	for (size_t i = 0; i < obstacleMap.oponentRobot.size(); i++)
	{
		if (obstacleMap.oponentRobot.at(i).getTTL() <= millis() - obstacleMap.oponentRobot.at(i).getLastTimeSeen())
			obstacleMap.oponentRobot.erase(obstacleMap.oponentRobot.begin() + i);
	}

	for (size_t i = 0; i < obstacleMap.toBeSpecified.size(); i++)
	{
		if (obstacleMap.toBeSpecified.at(i).getTTL() <= millis() - obstacleMap.toBeSpecified.at(i).getLastTimeSeen())
			obstacleMap.toBeSpecified.erase(obstacleMap.toBeSpecified.begin() + i);
	}
}

void Table::updateMoveAllowed(DetectionPoint tabDetection[NB_CAPTEURS], const RelativeObstacleMap & relativeObstacleMap)
{
	forwardMoveAllowed = true;
	backwardMoveAllowed = true;

	// Capteurs AVANT
	if ((tabDetection[4].associatedObstacleType == TO_BE_SPECIFIED || tabDetection[5].associatedObstacleType == TO_BE_SPECIFIED) ||
		((relativeObstacleMap.avantGauche <= CONTACT_OBSTACLE || relativeObstacleMap.avantDroit <= CONTACT_OBSTACLE) && lastChanceAvoiding)
		)
	{
		forwardMoveAllowed = false;
	}

	// Capteurs ARRIERE
	if ((tabDetection[6].associatedObstacleType == TO_BE_SPECIFIED || tabDetection[7].associatedObstacleType == TO_BE_SPECIFIED) ||
		((relativeObstacleMap.arriereGauche <= CONTACT_OBSTACLE || relativeObstacleMap.arriereDroit <= CONTACT_OBSTACLE) && lastChanceAvoiding)
		)
	{
		backwardMoveAllowed = false;
	}
}

bool Table::isObstacleOnTrajectory(const Obstacle & obstacle, const UnitMove & unitMove, const Position & notrePosition, float moveProgress)
{
	Position centreObstacle;
	obstacle.getCenter(centreObstacle);
	float rObstacle = obstacle.getRadius() + ROBOT_EXT_RADIUS;
	float moveLength = unitMove.getLengthMm() * (1 - moveProgress);
	if (moveLength < 100 && moveLength >= 0)
	{
		moveLength = 100;
	}
	else if (moveLength > 300)
	{
		moveLength = 300;
	}
	else if (moveLength > -100 && moveLength < 0)
	{
		moveLength = -100;
	}
	else if (moveLength < -300)
	{
		moveLength = -300;
	}

	if (unitMove.getBendRadiusTicks() == 0)
	{
		return false;
	}
	else
	{
		float xHorizon, yHorizon;
		xHorizon = cos(notrePosition.orientation) * moveLength + notrePosition.x;
		yHorizon = sin(notrePosition.orientation) * moveLength + notrePosition.y;
		return isObstacleInSight(notrePosition, centreObstacle, rObstacle, xHorizon, yHorizon);
	}
}

bool Table::isObstacleCoherentWithSensor(const DetectionPoint & sensor, const Position & robotCenter, const ObstacleType & obstacleType, size_t obstacleID, float incertitude)
{
	if (obstacleType == MOVABLE_VISIBLE)
	{
		// Si on ne détecte aucun obstacle
		if (!sensor.isAnObstacle)
		{
			Position obstacleCenter;
			obstacleMap.movableVisible.at(obstacleID).getCenter(obstacleCenter);
			return !(isObstacleInSight(robotCenter, obstacleCenter, obstacleMap.movableVisible.at(obstacleID).getRadius(), sensor.x, sensor.y, incertitude));
		}
		else
		{
			return true;
		}
	}
	else
	{
		return true;
	}
}

bool Table::isTrajectoryAllowed(int movingDirection)
{
	if (movingDirection == 0)
	{
		return true;
	}
	else if (movingDirection > 0)
	{
		return forwardMoveAllowed;
	}
	else
	{
		return backwardMoveAllowed;
	}
}
