INTechSenpai/sumobot/programmation/sumobot/Obstacle.cpp

#include "Obstacle.h"

/* Initialisation de la classe Obstacle : initialement aucun objet n'est défini donc aucun n'est dans l'état "poussé" */
/* L'initialisation doit se faire ici, pour éviter les multiples définitions */
bool Obstacle::anObstacleIsPushed = false;
