INTechSenpai/sumobot/(commit log)

2015-12-22 maj modele 3D + ajout d'un début de circuit electronique
    [Capteur ToF.brd, Capteur ToF.sch, VL6180_Breakout_v10.brd, VL6180_Breakout_v10.sch, VL6180_Sensor_v10.brd, VL6180_Sensor_v10.sch]
2015-12-26 ajout d'un dÃebut d'UML et d'une description succinte de chacune des classes
2015-12-30 Maj de l'UML
2016-01-23 circuit electronique git status!
    [mainBoard.brd, mainBoard.sch]
2016-01-24 MAJ electronique (final version)
    [Capteur ToF.brd, Capteur ToF.sch, VL6180_Breakout_v10.brd, VL6180_Breakout_v10.sch, VL6180_Sensor_v10.brd, VL6180_Sensor_v10.sch, mainBoard.brd, mainBoard.sch]
2016-01-26 mecanique : mise a jour de la base du robot
    [mainBoard.brd]
2016-02-06 programmation : ajout du projet Teensy
    [mainBoard.brd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]
2016-02-17 mÃaj Code low level
    [mainBoard.brd]
2016-02-20 control des moteurs OK + controle tension des lipos fonctionnel
    [mainBoard.brd, mainBoard.sch]
2016-02-28 ajout des capteurs ToF dans le code bas niveau
2016-03-05 ùAjout de doc + code des capteurs IR
2016-03-06 affinement des classes obstacles
2016-03-07 ajout du code des capteurs noir-blanc
2016-03-07 mise a jour de RelativeObstacleMap.h et de Path.h
2016-03-07 ajout des differents noeuds possible dans pathfinding
2016-03-07 maj du fichier path.h pour la compatibilite haut/bas niveau
2016-03-08 capteurs noir/blanc enfin fonctionnels + maj RelativeObstacleMap (changement des types)
2016-03-08 Specification précide de la structure RelativeObstacleMap
2016-03-08 ajout de supports pour les capteurs + doc des emplacements des capteurs
2016-03-08 les vector sont triés
2016-03-09 detection des obstacles
2016-03-09 j'inclue les .h de malcolm
2016-03-09 gestion bas niveau des capteurs operationnelle pour TOUS les capteurs !
2016-03-10 pathfinding qui evite les ObstacleCercle
2016-03-10 changement sur la vitesse et petits tests
2016-03-10 Gestion de la vitesse de variation des capteurs
2016-03-10 changement pour la vitesse
2016-03-10 changement pour la vitesse 2
2016-03-10 la distance prend en compte l'ecart d'orientation
2016-03-10 all the sensors works... mais pas la table
2016-03-11 modifs de malcolm
2016-03-11 inclusion des bon .h
2016-03-11 debut de la fonction pour sortir un objet Trajectory
2016-03-12 encore ces putains de capteurs au sol
2016-03-12 recupere le type de la trajectoire a la fin
2016-03-14 possibilité de calculer une trajectoire soit a partir de 3 points soit a partir de deux positions en precisant les orientations
2016-03-16 ajout des modulo sur les orientation dans pathfinding
2016-03-16 changements pour les marges de capteurs cotés
2016-03-16 changements pour les commentaires
2016-03-16 debut de la classe robot et strategy
2016-03-18 avancée dans la strategie
2016-03-18 ajout sequence de demarrage permettant de replier le robot
2016-03-18 changements non perdu si bord detecter et robot proche de nous
2016-03-18 code de test + maj motioncontrolsystem
2016-03-18 ajout desengagement en cas de detection de bord
2016-03-18 changement prototype du getPosition
2016-03-18 ARTHUR J'AURAIS TA PEAU git status! (met jai corrigé ton bug)
    [sumobot.ino]
2016-03-18 mise en place de la trajectoire courbe
2016-03-18 bug tourne sur lui meme capteurs
    [Table.cpp, pathfinding.cpp, sumobot.ino]
2016-03-18 test de trajectoire
2016-03-19 maj du detecteur de bords
2016-03-19 detection des bords OK
2016-03-19 maj timer desengagement
2016-03-19 Code qui gagne tous les match !
2016-03-20 Nettoyage du code apres Sumobot. Ajout d'une structure de test (CUnit) et corrections des problemes de portee des variables
    [BattControler.h, CUnit.h, MotionControlSystem.cpp, SensorMgr.h, Table.h, sumobot.ino, utils.c, utils.h]
2016-03-25 modif Obstacle + Table en prÃevision de la nouvelle archi du code
2016-04-11 la fonction pathfinding renvoie une trajectoire, prend en compte les rotations
2016-04-12 ajout des obstacles
2016-04-14 prend en compte maintenant tous les obstacles
2016-04-14 fonction de détection d'obstacle corrigée
    [pathfinding.cpp]
2016-04-16 modification pour prendre en compte le fait que XRadius et YRadius correspondent respectivement à la largeur et la hauteur de l'obstacle rectangle
2016-04-16 Correctifs du motionControlSystem : constantes de conversion tick mm radian + enchainement des mouvements
    [CUnit.h, MotionControlSystem.cpp, MotionControlSystem.h, Path.h, sumobot.ino]
2016-04-17 ajout detection de cote de table en debut de match
2016-04-17 corrections + interdit les rotations quand le robot est en train de pousser un objet
    [main.cpp, pathfinding.cpp, pathfinding.h]
2016-04-17 Ajout des prototypes de presque toutes les methodes de Robot.h avec leurs specifications
2016-04-18 concatenation des trajectoires
2016-04-18 prise en compte du cas ou le pathfinding apparait sur un obstacle non fixe
    [main.cpp, pathfinding.cpp, pathfinding.h]
2016-04-20 agrandissement de la taille des obstacles
2016-04-22 ajout de le fonction 'longer bord de table' non testee
2016-04-23 Début de match testé et approuvé. Script 'longe bord de table' en cours de réglages
2016-04-23 le script de fermeture des deux portes est fonctionnel et fiable du côté violet, fonctionnel du côté vert
2016-04-23 gestion plus intelligente des contraintes d'arrivées
2016-04-25 maj script close doors + progression de la gestiond des obstacles
2016-04-27 détection des obstacles OK (il ne manque plus que l'interprétation gros/petit obstacle)
2016-04-28 detection des obstacles OK git status Motherfucker ! (reste plus qu'à faire l'interprétation pour voir des robots adverses
2016-04-28 correction : la taille de la table était augmentée au lieu de diminuée pour prendre en compte la taille du robot
    [main.cpp, pathfinding.cpp]
2016-04-28 suppression d'un rayon de courbure pour le robot ce qui donne de meilleurs résultats
2016-04-29 ajout évitement OVERKILL (qui marche pas, mais je commit pour la beauté des calculs dégeu)
2016-05-03 dernier commit avant le départ à la coupe
2016-05-04 test fin de match yolo
